codex-modulex/uRinks/uRinks_v2.0.brd

## EAGLE design uRinks_v2.0.brd (2018-12-11)

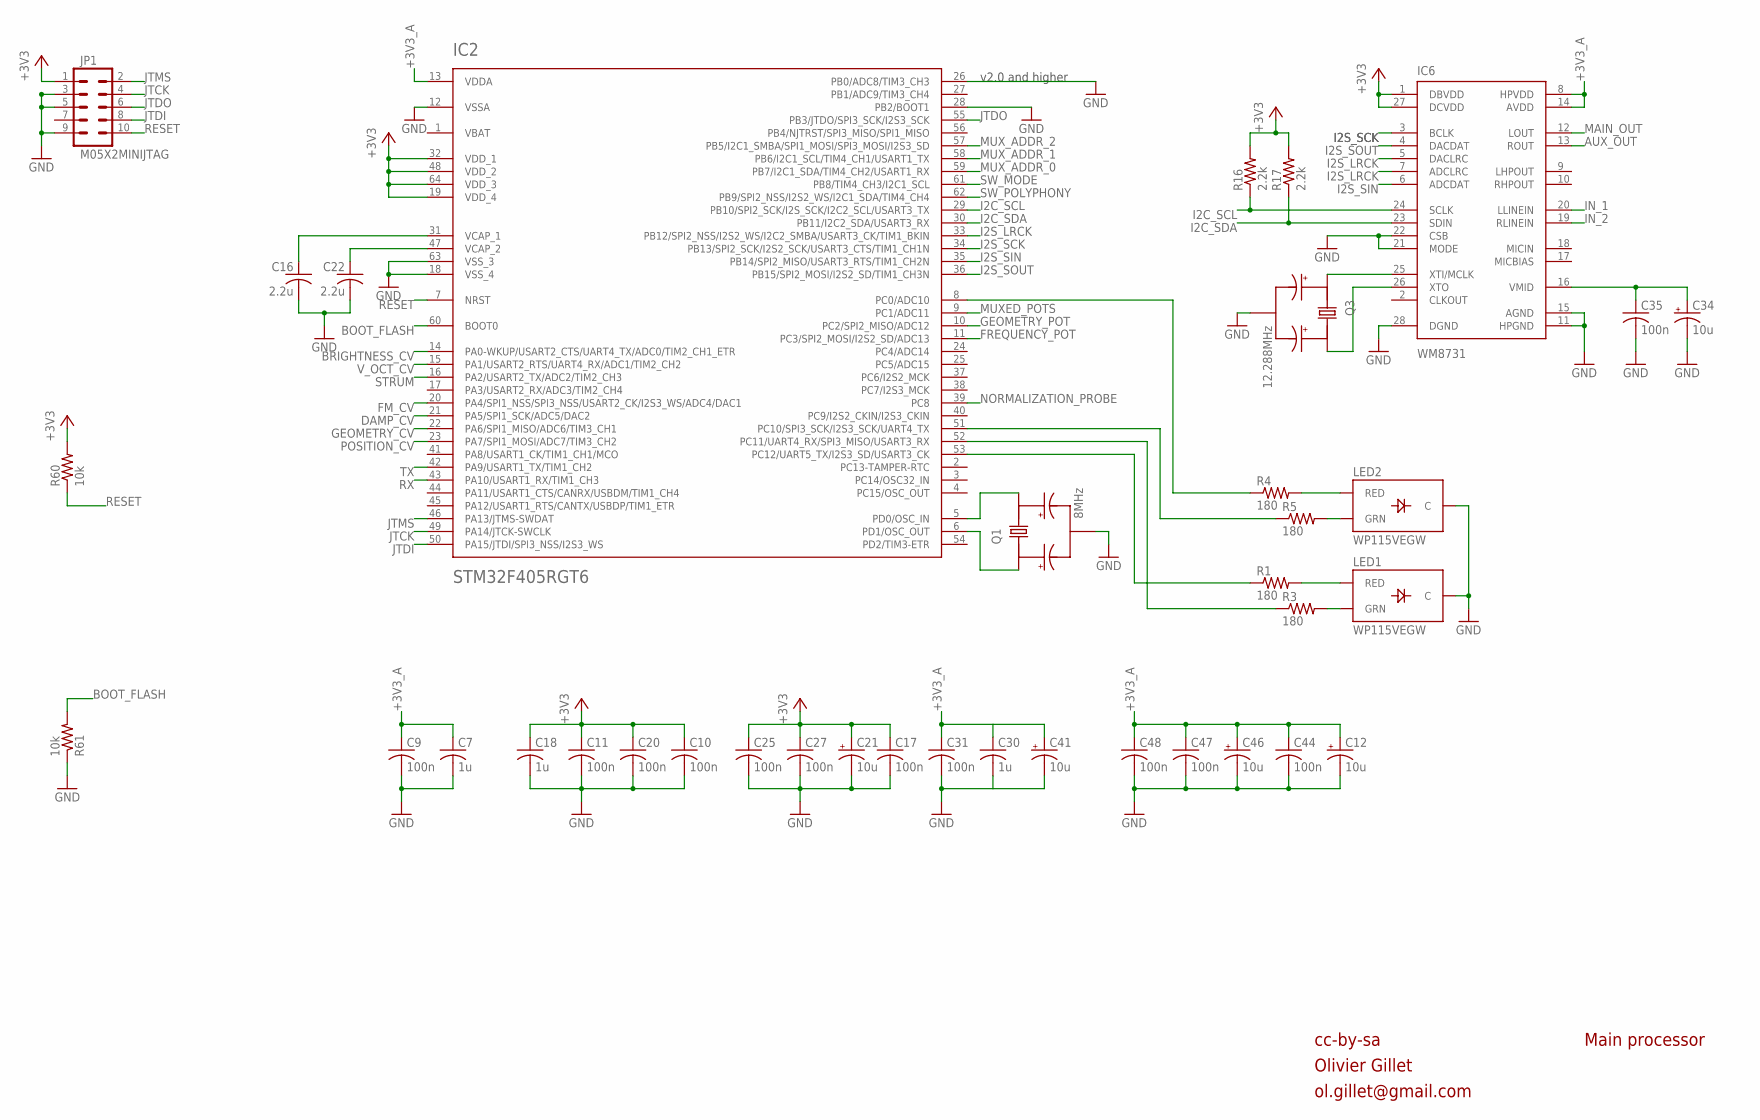
[picture p1: schematic uRinks_v2.0.sch, sheet 1]

Parts:
C7, C18, C30: 1u; C0603
C9, C10, C11, C17, C20, C25, C27, C31, C35, C44, C47, C48: 100n; C0603
C12, C21, C34, C41, C46: 10u; PANASONIC_A
C16, C22: 2.2u; C0805
IC2: STM32F405RGT6; TQFP-10X10-64
IC6: WM8731; SSOP28
JP1: M05X2MINIJTAG; 2X5-1.27
LED1, LED2: WP115VEGW; LED-BICOLOR-THROUGHHOLE
Q1: 8MHz; INSTRUO_CRYSTAL_SMALLER
Q3: 12.288MHz; INSTRUO_CRYSTAL_SMALLER
R1, R3, R4, R5: 180; R0603
R16, R17: 2.2k; R0603
R60, R61: 10k; R0603

Connections:
+3V3: C10.1, C11.1, C17.1, C18.1, C20.1, C21.+, C25.1, C27.1, IC2.19 (VDD_4), IC2.32 (VDD_1), IC2.48 (VDD_2), IC2.64 (VDD_3), IC6.1 (DBVDD), IC6.27 (DCVDD), JP1.1, R16.2, R17.2, R60.2; also elsewhere on the board
+3V3_A: C7.1, C9.1, C12.+, C30.1, C31.1, C41.+, C44.1, C46.+, C47.1, C48.1, IC2.13 (VDDA), IC6.8 (HPVDD), IC6.14 (AVDD); also elsewhere on the board
AUX_OUT: IC6.13 (ROUT); also elsewhere on the board
BOOT_FLASH: IC2.60 (BOOT0), R61.2
BRIGHTNESS_CV: IC2.14 (PA0-WKUP/USART2_CTS/UART4_TX/ADC0/TIM2_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); also elsewhere on the board
DAMP_CV: IC2.21 (PA5/SPI1_SCK/ADC5/DAC2); also elsewhere on the board
FM_CV: IC2.20 (PA4/SPI1_NSS/SPI3_NSS/USART2_CK/I2S3_WS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); also elsewhere on the board
FREQUENCY_POT: IC2.11 (PC3/SPI2_MOSI/I2S2_SD/ADC13); also elsewhere on the board
GEOMETRY_CV: IC2.22 (PA6/SPI1_MISO/ADC6/TIM3_CH1); also elsewhere on the board
GEOMETRY_POT: IC2.10 (PC2/SPI2_MISO/ADC12); also elsewhere on the board
GND: C7.2, C9.2, C10.2, C11.2, C12.-, C16.2, C17.2, C18.2, C20.2, C21.-, C22.2, C25.2, C27.2, C30.2, C31.2, C34.-, C35.2, C41.-, C44.2, C46.-, C47.2, C48.2, IC2.12 (VSSA), IC2.18 (VSS_4), IC2.26 (PB0/ADC8/TIM3_CH3), IC2.28 (PB2/BOOT1), IC2.63 (VSS_3), IC6.11 (HPGND), IC6.15 (AGND), IC6.21 (MODE), IC6.22 (CSB), IC6.28 (DGND), JP1.3, JP1.5, JP1.9, LED1.2 (C), LED2.2 (C), Q1.GND, Q3.GND, R61.1; also elsewhere on the board
I2C_SCL: IC2.29 (PB10/SPI2_SCK/I2S_SCK/I2C2_SCL/USART3_TX), IC6.24 (SCLK), R16.1
I2C_SDA: IC2.30 (PB11/I2C2_SDA/USART3_RX), IC6.23 (SDIN), R17.1
I2S_LRCK: IC2.33 (PB12/SPI2_NSS/I2S2_WS/I2C2_SMBA/USART3_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), IC6.5 (DACLRC), IC6.7 (ADCLRC)
I2S_SCK: IC2.34 (PB13/SPI2_SCK/I2S2_SCK/USART3_CTS/TIM1_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), IC6.3 (BCLK)
I2S_SIN: IC2.35 (PB14/SPI2_MISO/USART3_RTS/TIM1_CH2N), IC6.6 (ADCDAT)
I2S_SOUT: IC2.36 (PB15/SPI2_MOSI/I2S2_SD/TIM1_CH3N), IC6.4 (DACDAT)
IN_1: IC6.20 (LLINEIN); also elsewhere on the board
IN_2: IC6.19 (RLINEIN); also elsewhere on the board
JTCK: IC2.49 (PA14/JTCK-SWCLK), JP1.4
JTDI: IC2.50 (PA15/JTDI/SPI3_NSS/I2S3_WS), JP1.8
JTDO: IC2.55 (PB3/JTDO/SPI3_SCK/I2S3_SCK), JP1.6
JTMS: IC2.46 (PA13/JTMS-SWDAT), JP1.2
MAIN_OUT: IC6.12 (LOUT); also elsewhere on the board
MUXED_POTS: IC2.9 (PC1/ADC11); also elsewhere on the board
MUX_ADDR_0: IC2.59 (PB7/I2C1_SDA/TIM4_CH2/USART1_RX); also elsewhere on the board
MUX_ADDR_1: IC2.58 (PB6/I2C1_SCL/TIM4_CH1/USART1_TX); also elsewhere on the board
MUX_ADDR_2: IC2.57 (PB5/I2C1_SMBA/SPI1_MOSI/SPI3_MOSI/I2S3_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); also elsewhere on the board
unnamed: IC2.6 (PD1/OSC_OUT), Q1.X1
unnamed: IC2.5 (PD0/OSC_IN), Q1.X2
unnamed: LED1.3 (RED), R1.2
unnamed: C22.1, IC2.47 (VCAP_2)
unnamed: C34.+, C35.1, IC6.16 (VMID)
unnamed: C16.1, IC2.31 (VCAP_1)
unnamed: LED1.1 (GRN), R3.2
unnamed: LED2.3 (RED), R4.2
unnamed: LED2.1 (GRN), R5.2
unnamed: IC2.52 (PC11/UART4_RX/SPI3_MISO/USART3_RX), R3.1
unnamed: IC2.8 (PC0/ADC10), R4.1
unnamed: IC6.25 (XTI/MCLK), Q3.X1
unnamed: IC6.26 (XTO), Q3.X2
unnamed: IC2.53 (PC12/UART5_TX/I2S3_SD/USART3_CK), R1.1
unnamed: IC2.51 (PC10/SPI3_SCK/I2S3_SCK/UART4_TX), R5.1
NORMALIZATION_PROBE: IC2.39 (PC8); also elsewhere on the board
POSITION_CV: IC2.23 (PA7/SPI1_MOSI/ADC7/TIM3_CH2); also elsewhere on the board
RESET: IC2.7 (NRST), JP1.10, R60.1
RX: IC2.43 (PA10/USART1_RX/TIM1_CH3)
STRUM: IC2.16 (PA2/USART2_TX/ADC2/TIM2_CH3); also elsewhere on the board
SW_MODE: IC2.61 (PB8/TIM4_CH3/I2C1_SCL); also elsewhere on the board
SW_POLYPHONY: IC2.62 (PB9/SPI2_NSS/I2S2_WS/I2C1_SDA/TIM4_CH4); also elsewhere on the board
TX: IC2.42 (PA9/USART1_TX/TIM1_CH2)
VBAT: IC2.1 (VBAT)
V_OCT_CV: IC2.15 (PA1/USART2_RTS/UART4_RX/ADC1/TIM2_CH2); also elsewhere on the board

Notes on the sheet:
cc-by-sa
Olivier Gillet
ol.gillet@gmail.com
Main processor
v2.0 and higher

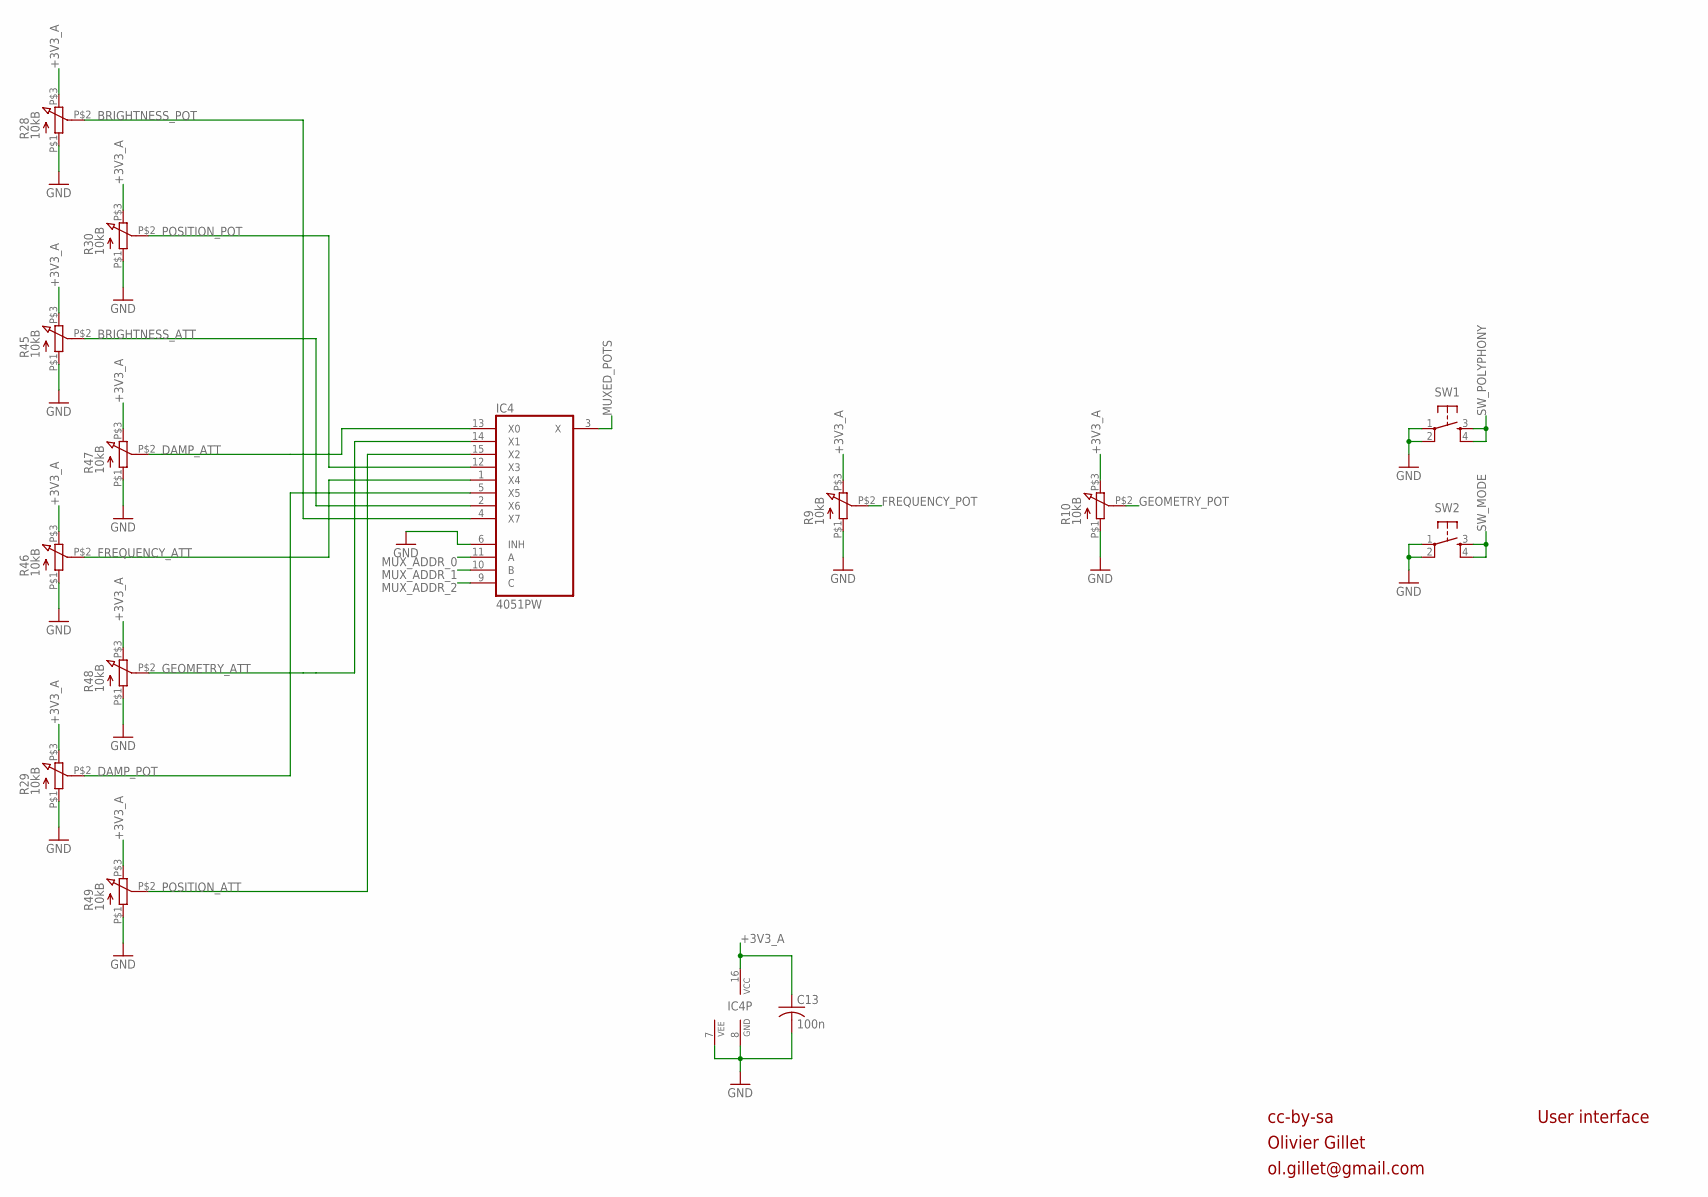
[picture p2: schematic uRinks_v2.0.sch, sheet 2]

Parts:
C13: 100n; C0603
IC4: 4051PW; TSSOP16
R9, R10, R28, R29, R30, R45, R46, R47, R48, R49: 10kB; INSTRUO_Q-POT2
SW1, SW2: TAC_SWITCHPTH; TACTILE-PTH

Connections:
+3V3_A: C13.1, IC4.16 (VCC), R9.P$3 (3), R10.P$3 (3), R28.P$3 (3), R29.P$3 (3), R30.P$3 (3), R45.P$3 (3), R46.P$3 (3), R47.P$3 (3), R48.P$3 (3), R49.P$3 (3); also elsewhere on the board
BRIGHTNESS_ATT: IC4.2 (X6), R45.P$2 (2)
BRIGHTNESS_POT: IC4.4 (X7), R28.P$2 (2)
DAMP_ATT: IC4.13 (X0), R47.P$2 (2)
DAMP_POT: IC4.5 (X5), R29.P$2 (2)
FREQUENCY_ATT: IC4.1 (X4), R46.P$2 (2)
FREQUENCY_POT: R9.P$2 (2); also elsewhere on the board
GEOMETRY_ATT: IC4.14 (X1), R48.P$2 (2)
GEOMETRY_POT: R10.P$2 (2); also elsewhere on the board
GND: C13.2, IC4.6 (INH), IC4.7 (VEE), IC4.8 (GND), R9.P$1 (1), R10.P$1 (1), R28.P$1 (1), R29.P$1 (1), R30.P$1 (1), R45.P$1 (1), R46.P$1 (1), R47.P$1 (1), R48.P$1 (1), R49.P$1 (1), SW1.1, SW1.2, SW2.1, SW2.2; also elsewhere on the board
MUXED_POTS: IC4.3 (X); also elsewhere on the board
MUX_ADDR_0: IC4.11 (A); also elsewhere on the board
MUX_ADDR_1: IC4.10 (B); also elsewhere on the board
MUX_ADDR_2: IC4.9 (C); also elsewhere on the board
POSITION_ATT: IC4.15 (X2), R49.P$2 (2)
POSITION_POT: IC4.12 (X3), R30.P$2 (2)
SW_MODE: SW2.3, SW2.4; also elsewhere on the board
SW_POLYPHONY: SW1.3, SW1.4; also elsewhere on the board

Notes on the sheet:
cc-by-sa
Olivier Gillet
ol.gillet@gmail.com
User interface

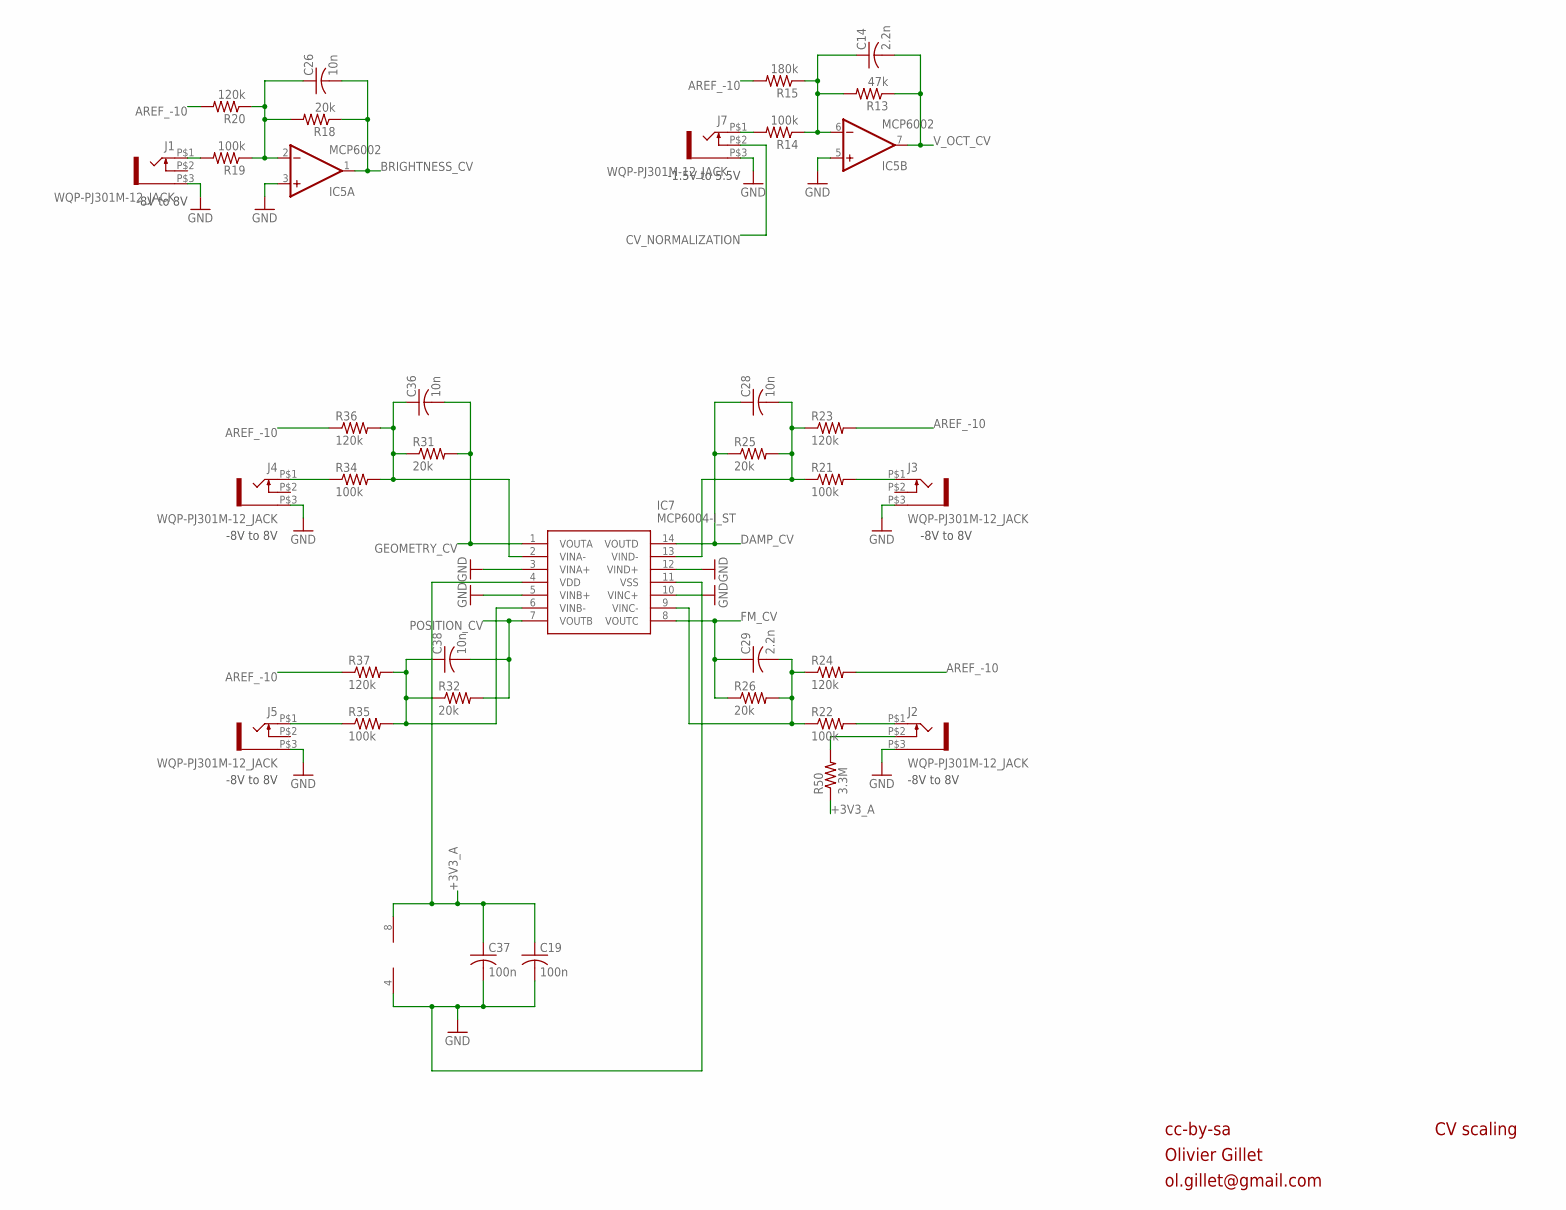
[picture p3: schematic uRinks_v2.0.sch, sheet 3]

Parts:
C14, C29: 2.2n; C0603
C19, C37: 100n; C0603
C26, C28, C36, C38: 10n; C0603
IC5: MCP6002; SO08
IC7: MCP6004-I_ST; SOP65P640X120-14N
J1, J2, J3, J4, J5, J7: WQP-PJ301M-12_JACK
R13: 47k; R0603
R14, R19, R21, R22, R34, R35: 100k; R0603
R15: 180k; R0603
R18, R25, R26, R31, R32: 20k; R0603
R20, R23, R24, R36, R37: 120k; R0603
R50: 3.3M; R0603

Connections:
+3V3_A: C19.1, C37.1, IC5.8 (V+), IC7.4 (VDD), R50.1; also elsewhere on the board
AREF_-10: R15.2, R20.2, R23.2, R24.2, R36.1, R37.1; also elsewhere on the board
BRIGHTNESS_CV: C26.2, IC5.1 (OUT), R18.1; also elsewhere on the board
CV_NORMALIZATION: J7.P$2 (3); also elsewhere on the board
DAMP_CV: C28.1, IC7.14 (VOUTD), R25.1; also elsewhere on the board
FM_CV: C29.1, IC7.8 (VOUTC), R26.1; also elsewhere on the board
GEOMETRY_CV: C36.2, IC7.1 (VOUTA), R31.2; also elsewhere on the board
GND: C19.2, C37.2, IC5.3 (+IN), IC5.4 (V-), IC5.5 (+IN), IC7.3 (VINA+), IC7.5 (VINB+), IC7.10 (VINC+), IC7.11 (VSS), IC7.12 (VIND+), J1.P$3 (1), J2.P$3 (1), J3.P$3 (1), J4.P$3 (1), J5.P$3 (1), J7.P$3 (1); also elsewhere on the board
unnamed: J1.P$1 (2), R19.2
unnamed: C26.1, IC5.2 (-IN), R18.2, R19.1, R20.1
unnamed: J7.P$1 (2), R14.2
unnamed: J3.P$1 (2), R21.2
unnamed: J2.P$1 (2), R22.2
unnamed: C29.2, IC7.9 (VINC-), R22.1, R24.1, R26.2
unnamed: C14.1, IC5.6 (-IN), R13.2, R14.1, R15.1
unnamed: C28.2, IC7.13 (VIND-), R21.1, R23.1, R25.2
unnamed: J4.P$1 (2), R34.1
unnamed: C36.1, IC7.2 (VINA-), R31.1, R34.2, R36.2
unnamed: J5.P$1 (2), R35.1
unnamed: C38.1, IC7.6 (VINB-), R32.1, R35.2, R37.2
unnamed: J2.P$2 (3), R50.2
POSITION_CV: C38.2, IC7.7 (VOUTB), R32.2; also elsewhere on the board
V_OCT_CV: C14.2, IC5.7 (OUT), R13.1; also elsewhere on the board

Notes on the sheet:
cc-by-sa
Olivier Gillet
ol.gillet@gmail.com
CV scaling
-8V to 8V
-1.5V to 5.5V

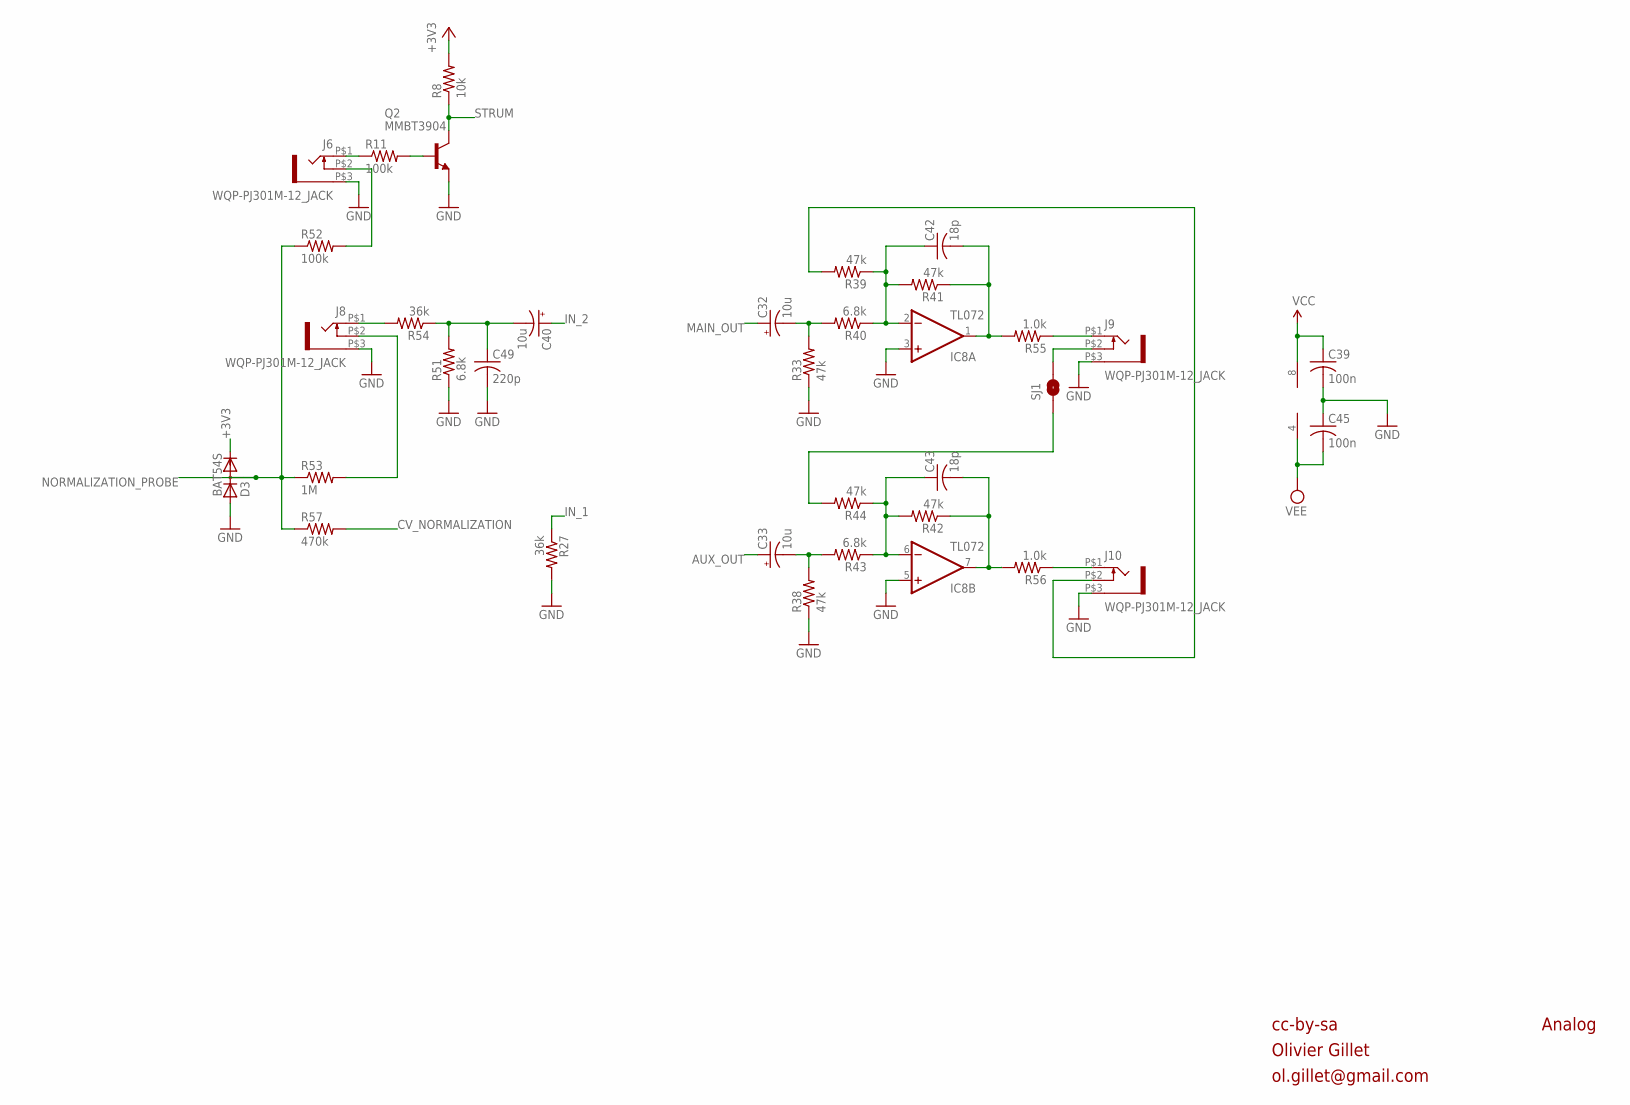
[picture p4: schematic uRinks_v2.0.sch, sheet 4]

Parts:
C32, C33, C40: 10u; PANASONIC_A
C39, C45: 100n; C0603
C42, C43: 18p; C0603
C49: 220p; C0603
D3: BAT54S; SOT23
IC8: TL072; SO08
J6, J8, J9, J10: WQP-PJ301M-12_JACK
Q2: MMBT3904; SOT23-BEC
R8: 10k; R0603
R11, R52: 100k; R0603
R27, R54: 36k; R0603
R33, R38, R39, R41, R42, R44: 47k; R0603
R40, R43, R51: 6.8k; R0603
R53: 1M; R0603
R55, R56: 1.0k; R0603
R57: 470k; R0603
SJ1: SOLDERJUMPERNC2; SJ_2S-NOTRACE

Connections:
+3V3: D3.2 (C), R8.2; also elsewhere on the board
AUX_OUT: C33.+; also elsewhere on the board
CV_NORMALIZATION: R57.2; also elsewhere on the board
GND: C39.2, C45.1, C49.2, D3.1 (A), IC8.3 (+IN), IC8.5 (+IN), J6.P$3 (1), J8.P$3 (1), J9.P$3 (1), J10.P$3 (1), Q2.E, R27.2, R33.1, R38.1, R51.1; also elsewhere on the board
IN_1: R27.1; also elsewhere on the board
IN_2: C40.+; also elsewhere on the board
MAIN_OUT: C32.+; also elsewhere on the board
unnamed: J6.P$1 (2), R11.1
unnamed: C40.-, C49.1, R51.2, R54.1
unnamed: J6.P$2 (3), R52.2
unnamed: J8.P$1 (2), R54.2
unnamed: C33.-, R38.2, R43.2
unnamed: C43.1, IC8.6 (-IN), R42.2, R43.1, R44.1
unnamed: C43.2, IC8.7 (OUT), R42.1, R56.2
unnamed: J10.P$1 (2), R56.1
unnamed: C32.-, R33.2, R40.2
unnamed: C42.1, IC8.2 (-IN), R39.1, R40.1, R41.2
unnamed: C42.2, IC8.1 (OUT), R41.1, R55.2
unnamed: J9.P$1 (2), R55.1
unnamed: J8.P$2 (3), R53.2
unnamed: J10.P$2 (3), R39.2
unnamed: R44.2, SJ1.1
unnamed: J9.P$2 (3), SJ1.2
unnamed: Q2.B, R11.2
NORMALIZATION_PROBE: D3.3 (AC), R52.1, R53.1, R57.1; also elsewhere on the board
STRUM: Q2.C, R8.1; also elsewhere on the board
VCC: C39.1, IC8.8 (V+); also elsewhere on the board
VEE: C45.2, IC8.4 (V-); also elsewhere on the board

Notes on the sheet:
cc-by-sa
Olivier Gillet
ol.gillet@gmail.com
Analog

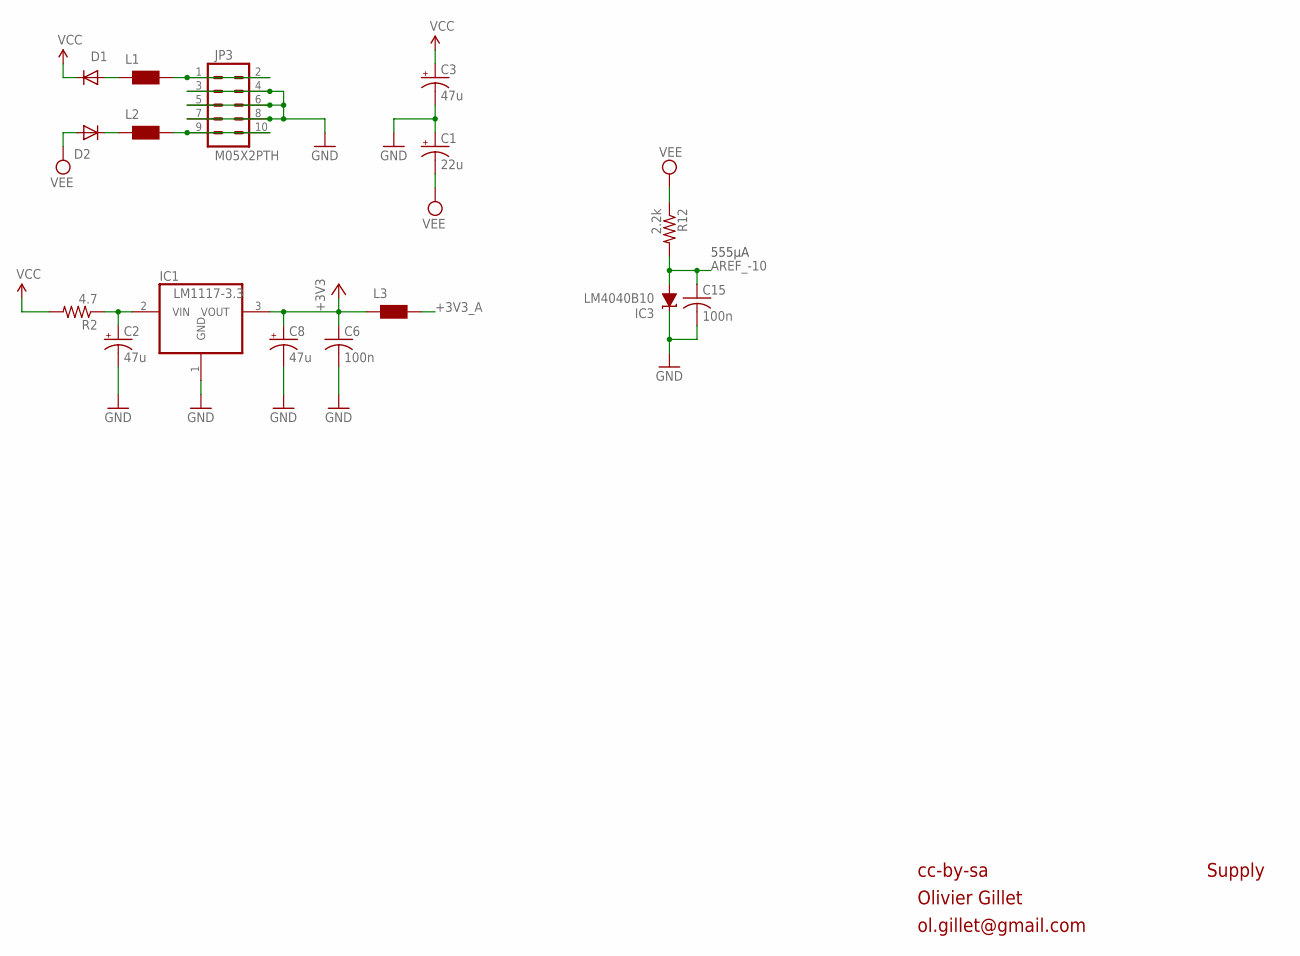
[picture p5: schematic uRinks_v2.0.sch, sheet 5]

Parts:
C1: 22u; PANASONIC_C
C2, C3, C8: 47u; PANASONIC_D
C6, C15: 100n; C0603
D1, D2: 1N5819HW; SOD123
IC1: LM1117-3.3; TO252
IC3: LM4040B10; DBZ_R-PDSO-G3
JP3: M05X2PTH; AVR_ICSP
L1, L2, L3: WE-CBF_0603; 0603
R2: 4.7; R1206
R12: 2.2k; R0603

Connections:
+3V3: C6.1, C8.+, IC1.3 (VOUT), L3.1; also elsewhere on the board
+3V3_A: L3.2; also elsewhere on the board
AREF_-10: C15.1, IC3.2 (A), R12.2; also elsewhere on the board
GND: C1.+, C2.-, C3.-, C6.2, C8.-, C15.2, IC1.1 (GND), IC3.1 (C), JP3.3, JP3.4, JP3.5, JP3.6, JP3.7, JP3.8; also elsewhere on the board
unnamed: C2.+, IC1.2 (VIN), R2.1
unnamed: D1.A, L1.1
unnamed: D2.C, L2.1
unnamed: JP3.1, JP3.2, L1.2
unnamed: JP3.9, JP3.10, L2.2
VCC: C3.+, D1.C, R2.2; also elsewhere on the board
VEE: C1.-, D2.A, R12.1; also elsewhere on the board

Notes on the sheet:
555µA
cc-by-sa
Olivier Gillet
ol.gillet@gmail.com
Supply

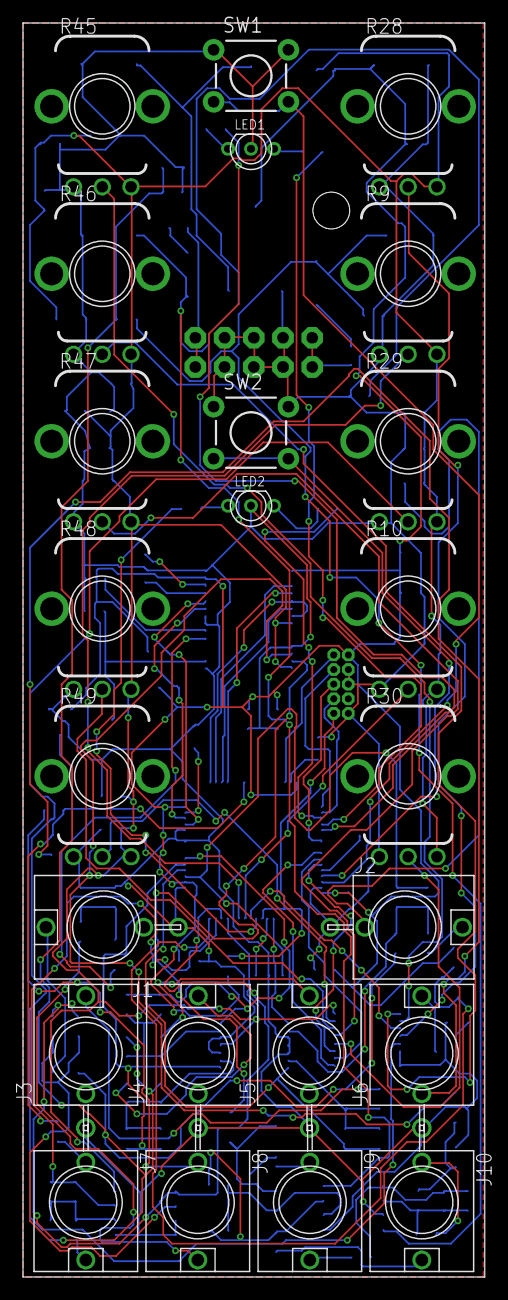
[picture p6: board uRinks_v2.0.brd from above]

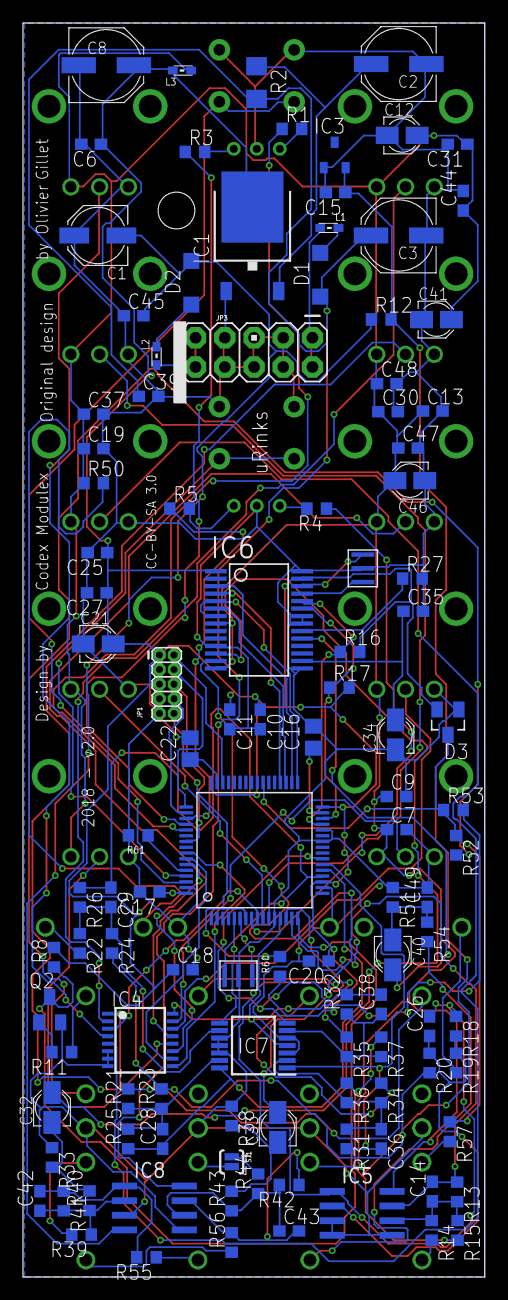
[picture p7: board uRinks_v2.0.brd from below]

Board: 2 copper layers, 40.1 x 109.0 mm, 136 parts (112 on the bottom side), 97 nets.
