codex-modulex/uRinks/(notices)

Notices in the files:
uRinks_v2.0.brd:
CC-BY-SA 3.0
